Zaion-BM/SWAN_BSc_Version/README.md

# SWAN BSc Thesis
Smart Watering Automation Network (SWAN) is a university thesis project at BME-VIK-MIT

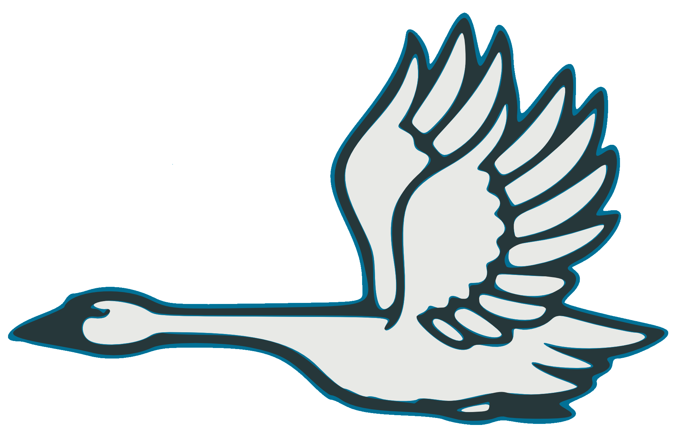
[picture p1: swan_logo.png]
SWAN logo
