Zaion-BM/SWAN_BSc_Version/Documents/neslab_prezi_hpd5lb.pptx

## Talaj nedvességtartalom mérés IoT eszközzel

Berta Máté
Konzulens:
Naszály Gábor

## Feladat

- Önálló laboratórium tanulságaiból kiindulva IoT alapú öntözőrendszer implementálása
- Talaj nedvességtartalom mérés kapacitív szenzorral
- A megoldás során elkészül:
  - Kapcsolási rajz és NYÁK
  - Szoftver µC-re
  - Szoftver központi számítógépre

## Rendszerterv 1.

Smart Watering Automation Network– S.W.A.N.

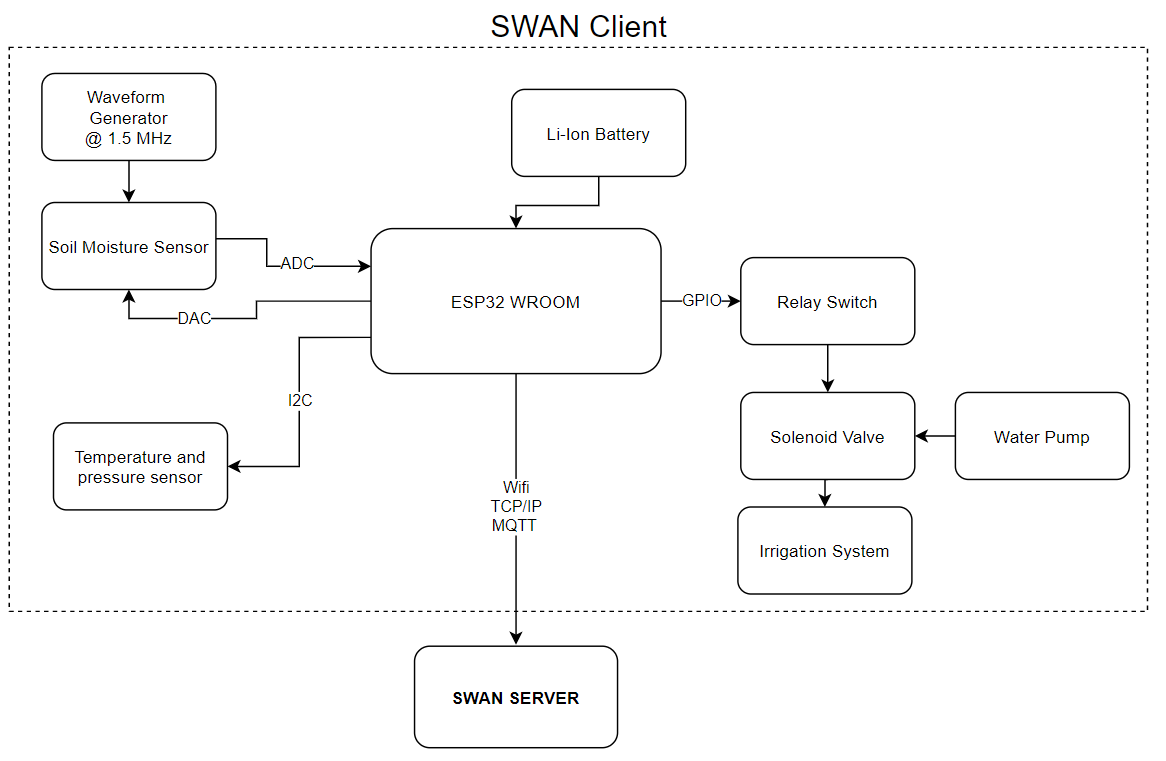
[picture p2: figure]

## Rendszerterv 2.

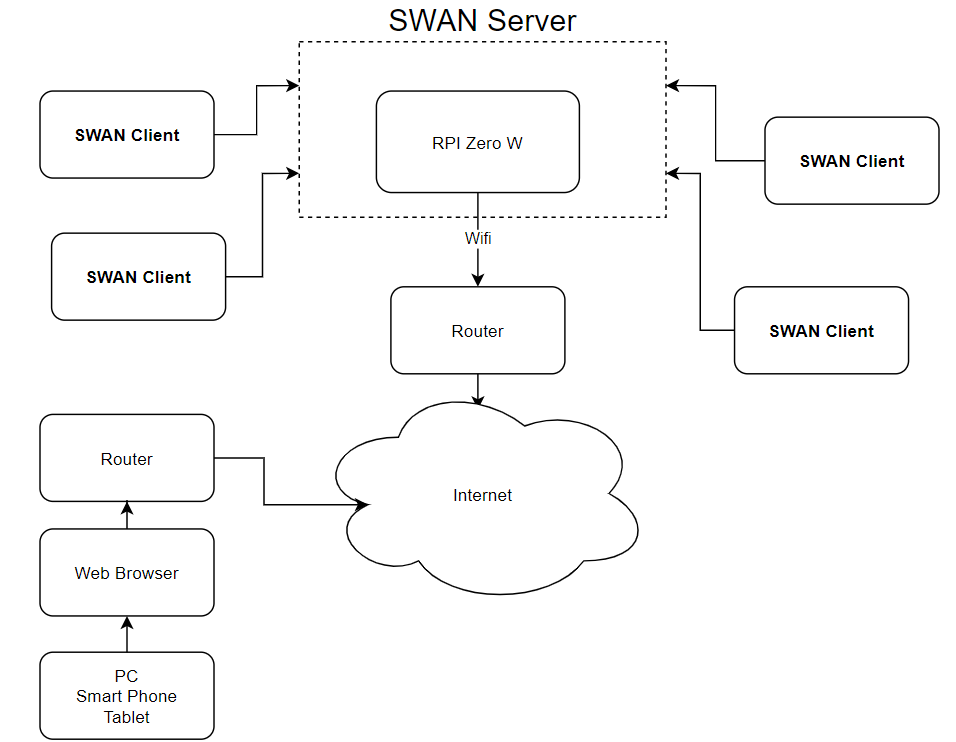
[picture p3: figure]

## Kapacitív talaj nedvességtartalom mérés

- S[%] = (m_(H2O))/(m_(talaj))
- Talajból kioldott ionok
- ε_r^(∗) = ε_r^(′) − j∙ε_r^(′′) = ε_r^(′) − j(ε_(relax)^(′′) + (σ_(dc))/(2πfε_0))
- C = ε_r^(∗) ε_0 G_0
- A kapacitás több fontos tényezőtől függ:
  - Frekvencia
  - Talaj vezetőképessége (talaj minőség)
  - Szenzor geometria

## Eredeti és módosított szenzor kapcsolási rajza

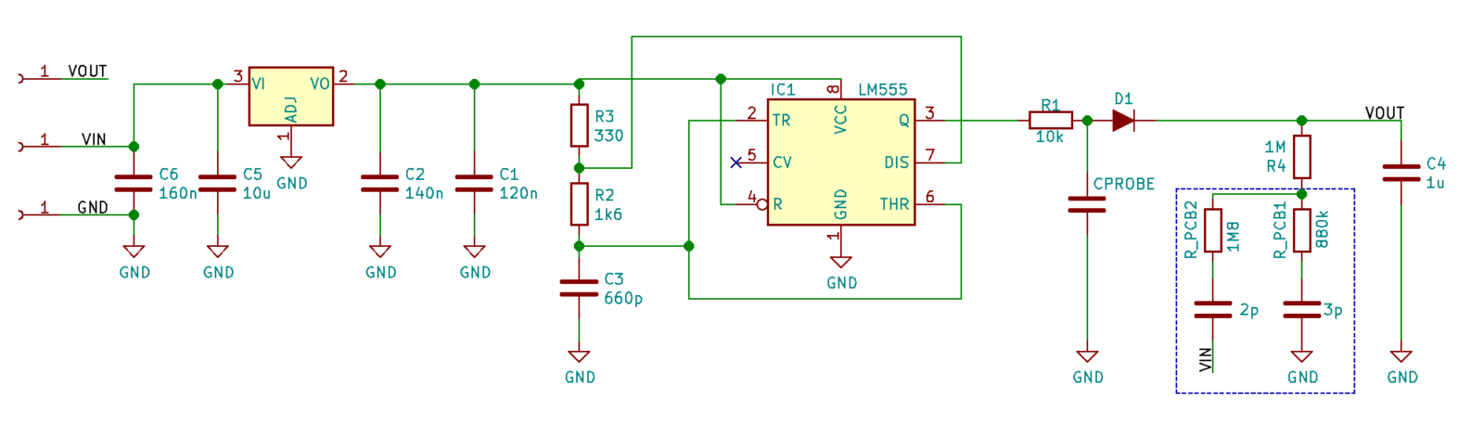
[picture p4: figure]
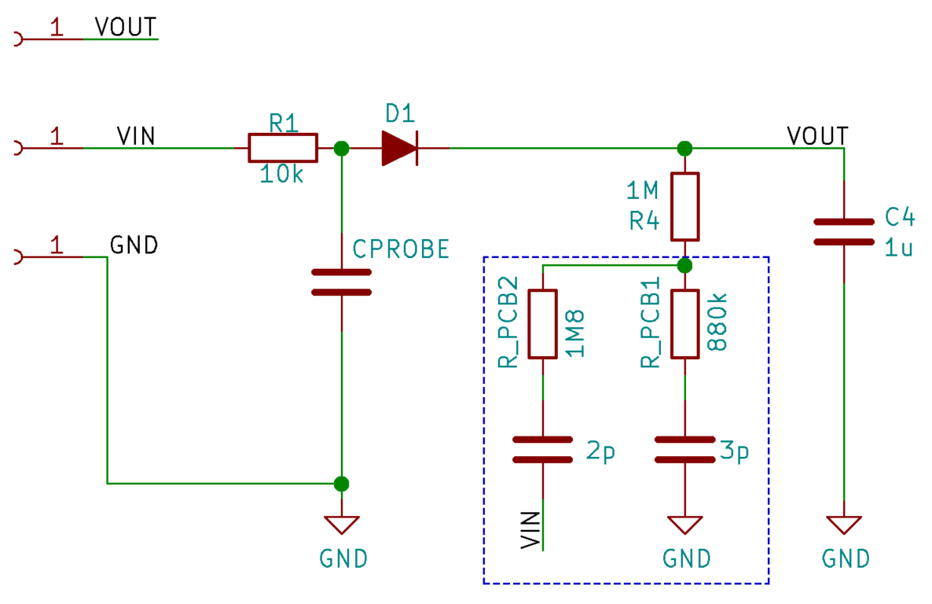
[picture p5: figure]
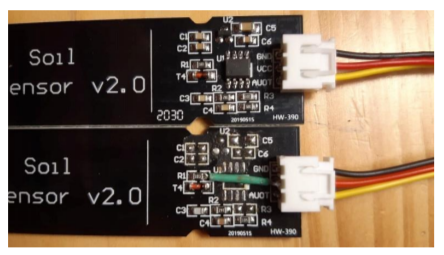
[picture p6: figure]

## Kalibrációs mérés 1

- Célja kettős! (karakterisztika, vizsgálódás)
- Metodikája szakirodalomból átvett

Tanulságai:
Szenzor geometria jelentős fontosságú
Gerjesztőjel spektruma nem okoz szignifikáns változást a karakterisztikában

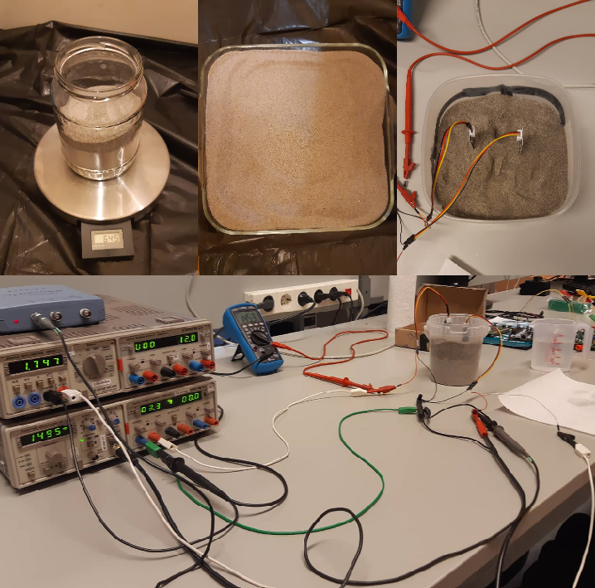
[picture p7: figure]

## Kalibrációs mérés 2

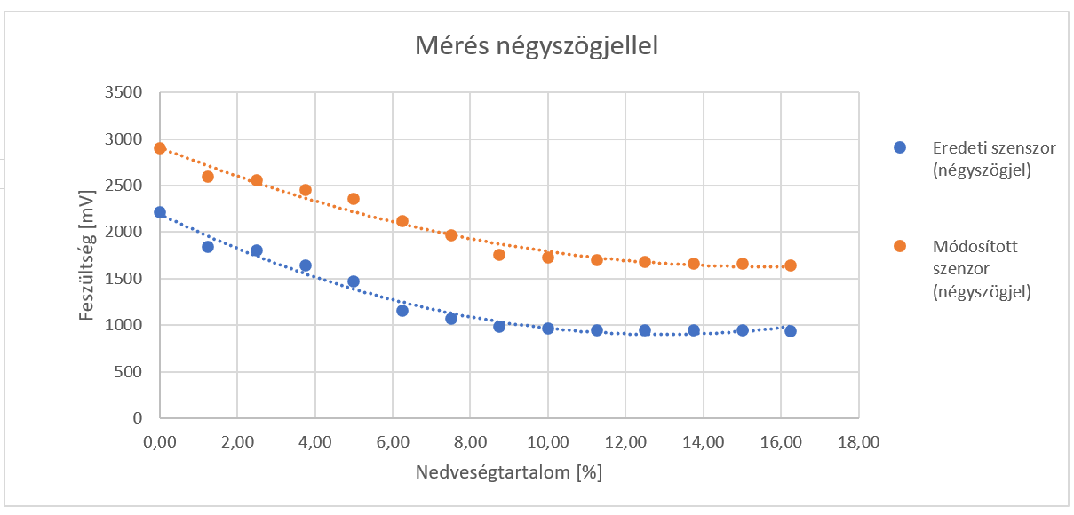
[picture p8: figure]

- Karakterisztika jellege nem változik
- „Lineáris” szakaszok meredeksége
- SWAN kliens mérőjele négyszögjel

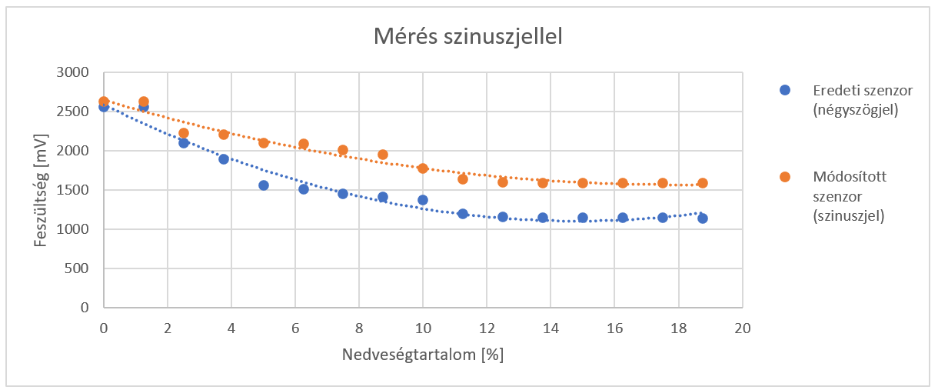
[picture p9: figure]

## Hardver követelmények (SWAN kliens)

- Akkumulátoros üzem
- Mágnes szelep vezérlése
- Alacsony költség (egyszerre több kliens használatának céljából)
- Kültéri villanyszereléshez használt IP65 doboz határozta meg a méreteket

## Szoftver követelmények (SWAN kliens & szerver)

- Kliens
  - Alacsony fogyasztás
  - Megbízható működés (beavatkozó szerv hiba esetén ne lépjen működésbe)
  - Több kliensre kerül a firmware
- Szerver:
  - Több kliens kezelésére alkalmas
  - Gyors reakció idő
  - Folyamatos elérhetőség

## Hardver implementáció

- µC működéséhez szükséges elemek
  - Passzív komponensek + csökkentett zajú környezet
- Tápfeszültség előállító hálózat
  - LDO 3.3V, 1A, 250mV dropout, 0.1 µA (shutdown)
- Akkumulátor töltő áramkör
- I2C & UART busz
- Galvanikusan leválasztott relé kapcsolás
- Mérőjel hardveres előállítása (!)
- ESD és fordított polaritás védelem

## Kliens PCB

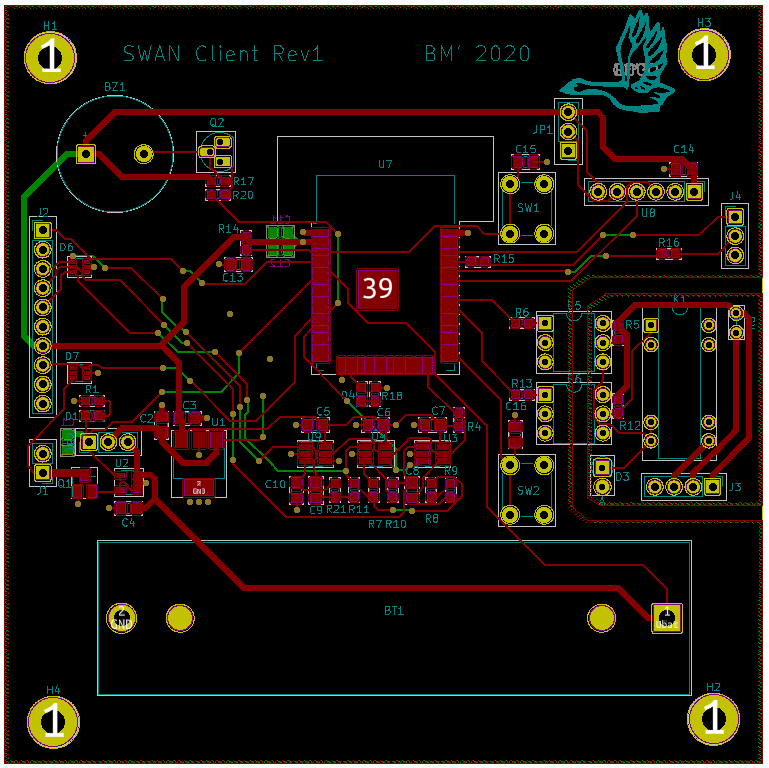
[picture p10: figure]
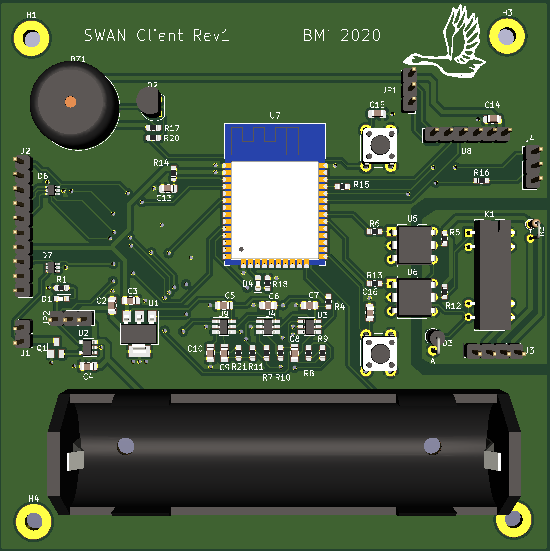
[picture p11: figure]

## Firmware implementáció 1.

- FreeRTOS módosított változata
  - xTaskCreatePinnedToCore(), vTaskSuspendAll()
- Deep sleep (fejlesztőkörnyezet korlátozó tényező)
  - 10µA
- Double -> Float
- PubSubClient (!)
- ArduinoJSON v6

## Firmware implementáció 2.

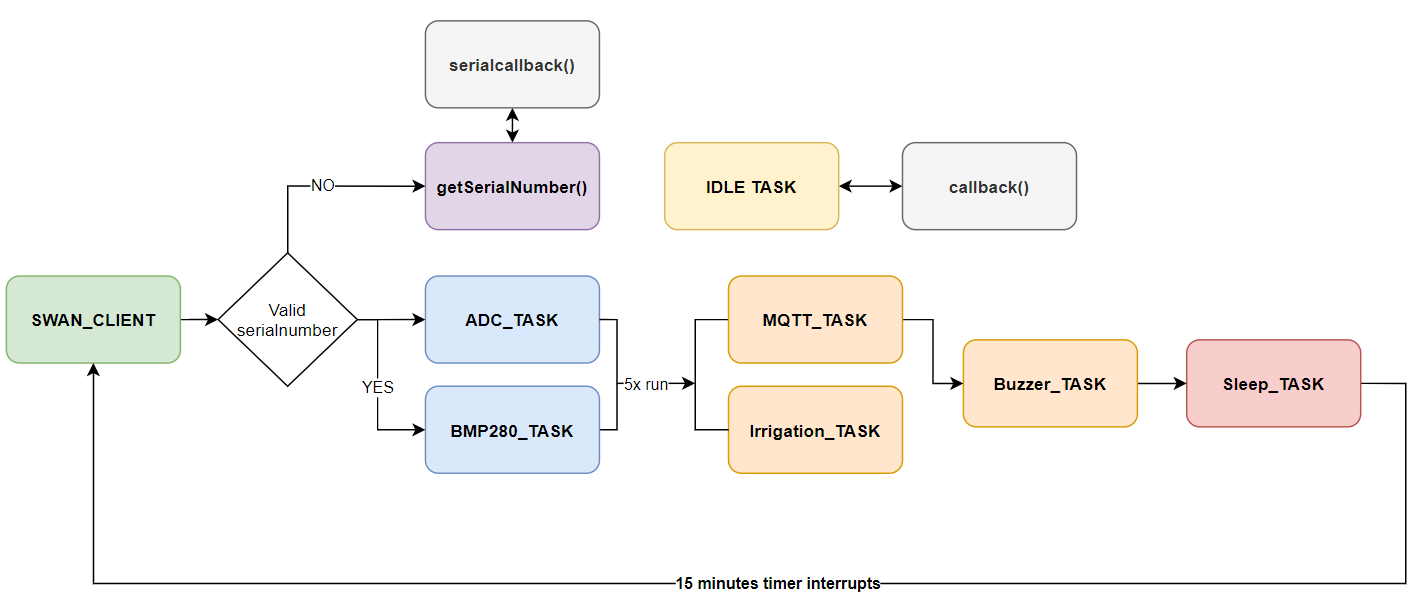
[picture p12: figure]

## Szerver implementáció 1.

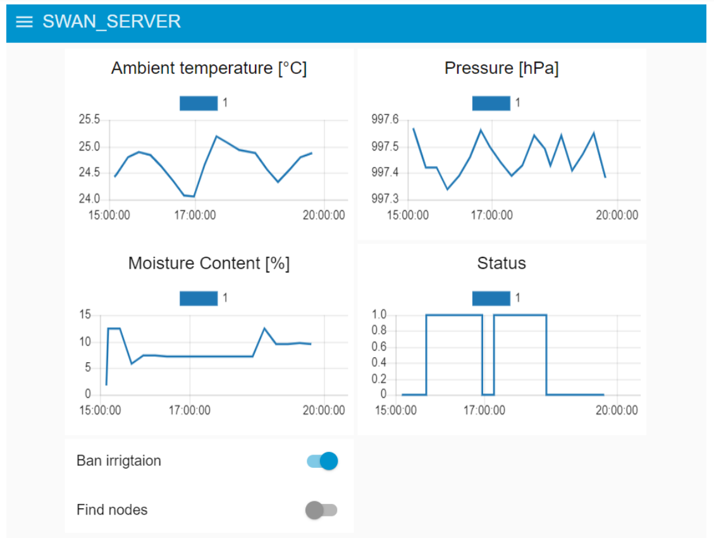
[picture p13: figure]

- Raspberry Pi Zero W
- DietPi
- NodeRED
  - SQLite
  - Mosquitto

## Szerver implementáció 2.

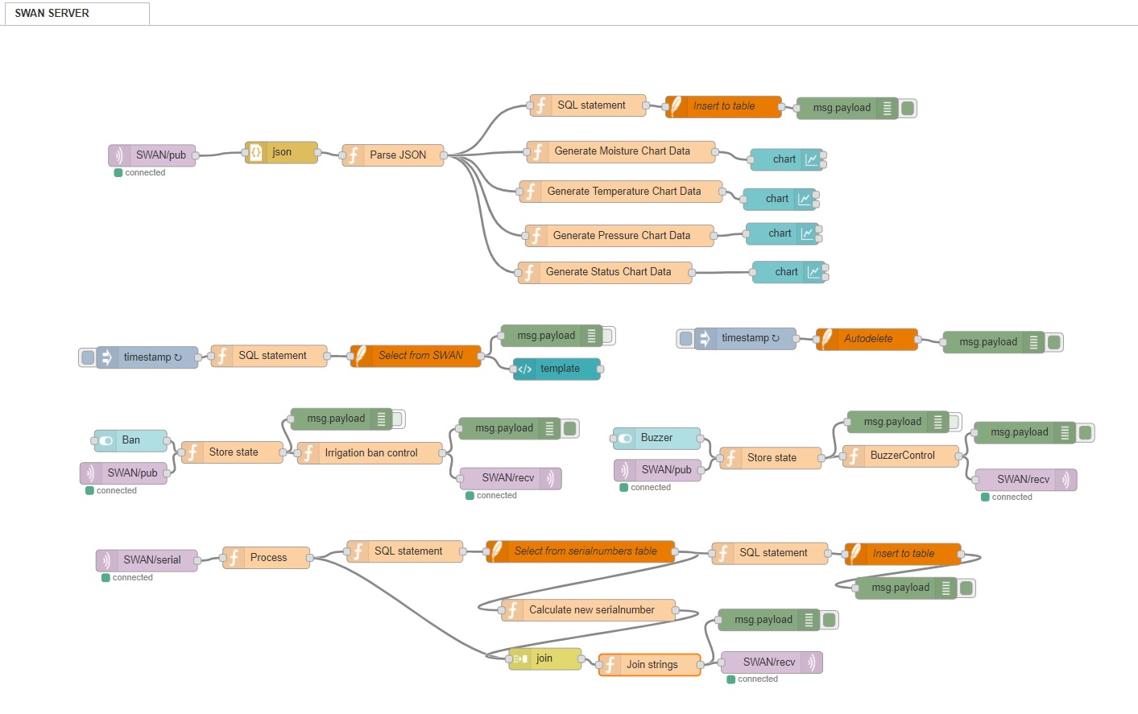
[picture p14: figure]

## Eredmények és továbbfejlesztési lehetőségek

- Eredmények:
  - Működő prototípus
  - Sikeres talaj nedvességtartalom mérés
  - 2021 nyarán „éles” körülmények között tesztelhető
- Tovább fejlesztési lehetőségek:
  - Átlag fogyasztás csökkentése ( ~4 mA, ~26 nap)
  - Költség csökkentése (akkumulátor költsége 22%)
  - Szenzor geometriájának változtatása
  - Szoftver időzítések optimalizálása
  - Debug üzenetek elhagyása (minimalizálás)

## Bírálói kérdések megválaszolása

- Adjon javaslatot a WiFi-n alapuló vezeték nélküli kapcsolat alternatívájára, amely alacsony fogyasztású rádiós összeköttetést valósíthat meg a rendszerkomponensek között.
  - LoRAWAN
    - Class A működéssel
- Adjon javaslatot alternatív energiaellátásra, amellyel az akkumulátor töltése megoldható. Milyen költségvonzata van egy ilyen rendszerkomponensnek?
  - Energy harvesting jellegű megoldás
    - Pl. Napelemcella
      - Cella : 1000 Ft - 8000 Ft (4-5W)
      - Boost SMPS ~ 1000 Ft (4-5W)
      - Kisebb akkumulátor sokkal olcsóbban elérhető
