Zaion-BM/SWAN_BSc_Version/szinusz.png

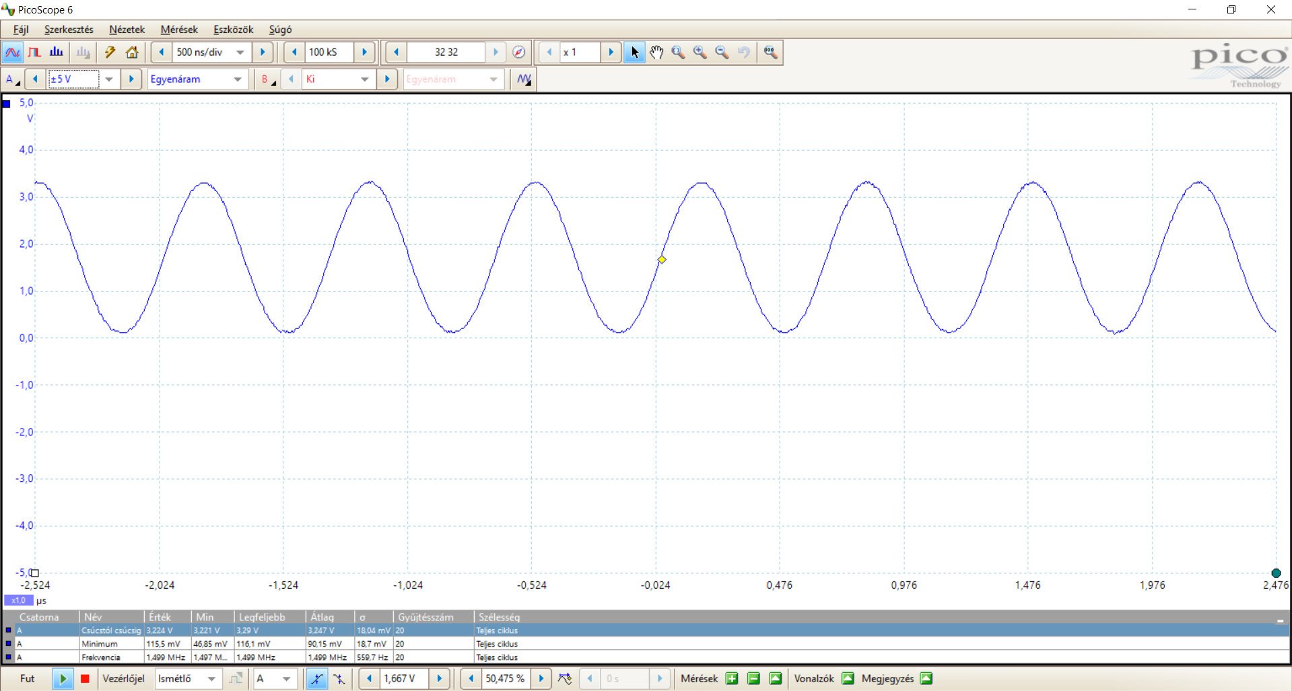
szinusz.png
