Zaion-BM/SWAN_BSc_Version/System design/SWAN_Rendszerterv.pdf

# SWAN Client

# Rendszerterv

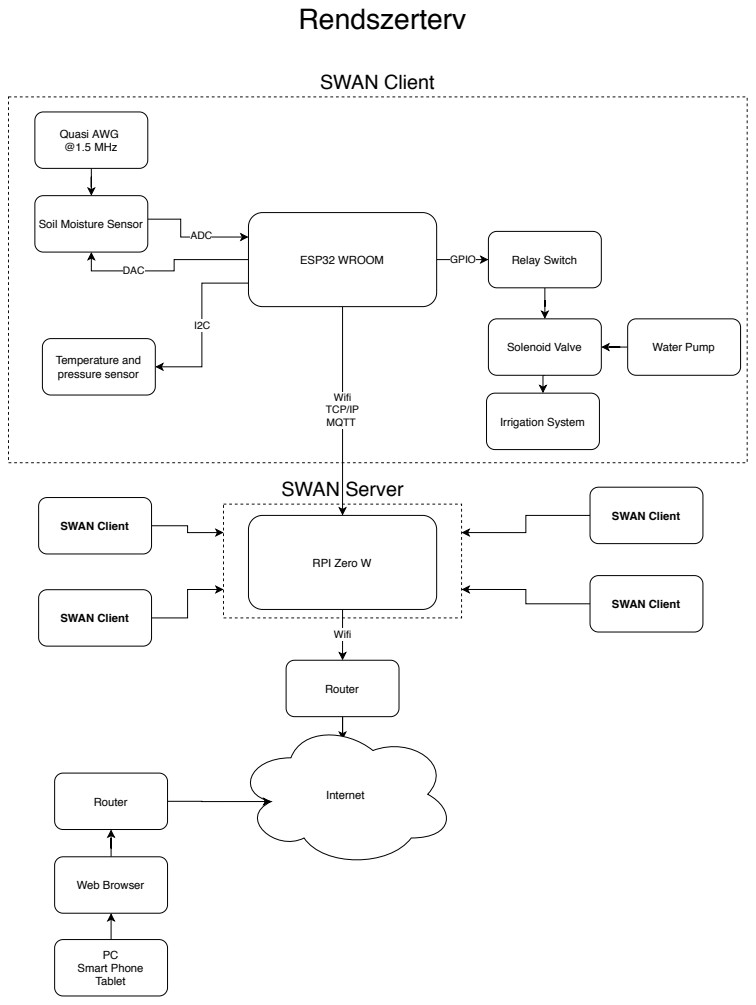
[picture p89: page 1]
ADC; GPIO; Wifi TCP/IP MQTT; DAC; ESP32 WROOM; Wifi; RPI Zero W; Temperature and pressure sensor; Relay Switch; Solenoid Valve; Water Pump; Irrigation System; Router; Internet; SWAN Server; Web Browser; PC Smart Phone Tablet; SWAN Client; Quasi AWG @1.5 MHz

Soil Moisture Sensor
