Zaion-BM/SWAN_BSc_Version/SWAN_Client_Rev0/schematic.pdf

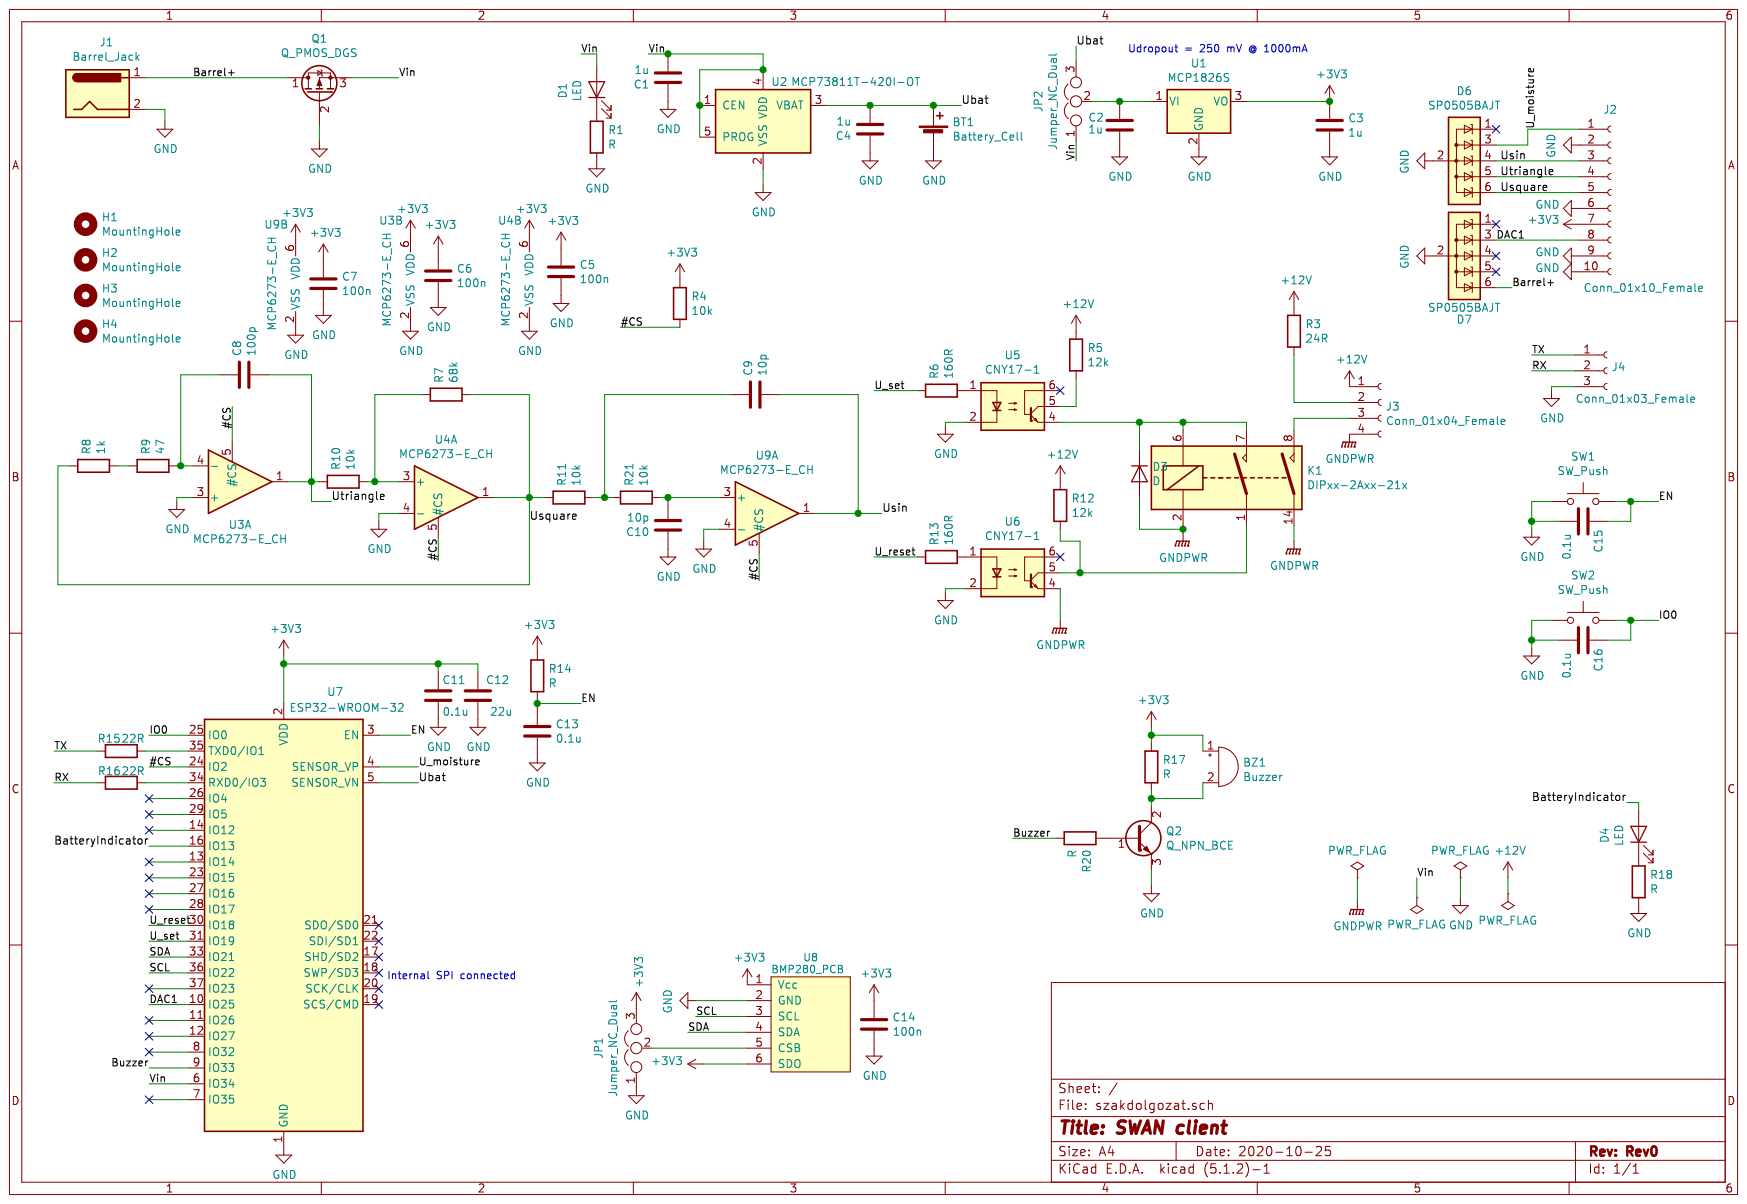
[picture p90: page 1]
