Zaion-BM/SWAN_BSc_Version/SWAN_Client_Rev0/OutJob/szakdolgozat-B_Cu.pdf

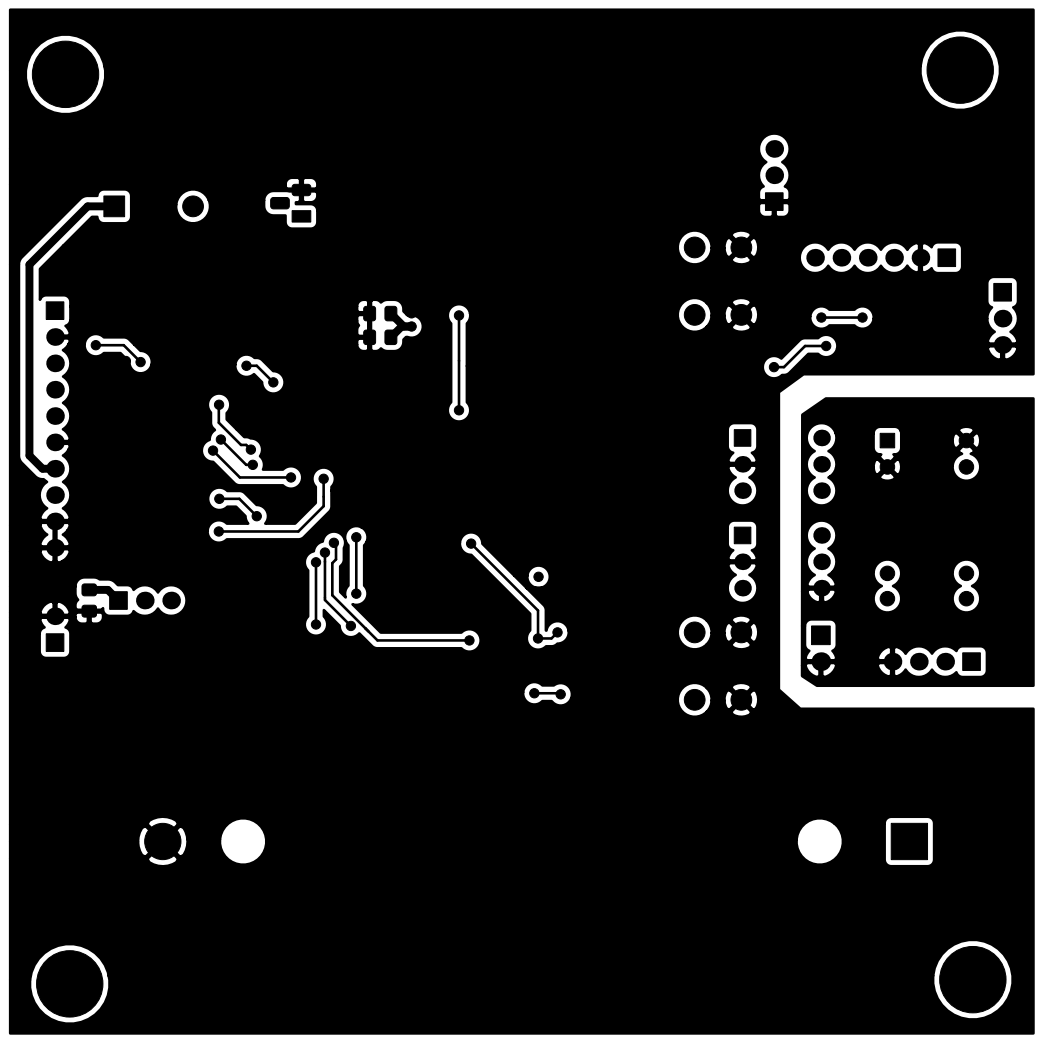
[picture p91: page 1]
