Zaion-BM/SWAN_BSc_Version/SWAN_Client_Rev0/OutJob/szakdolgozat-B_Mask.pdf

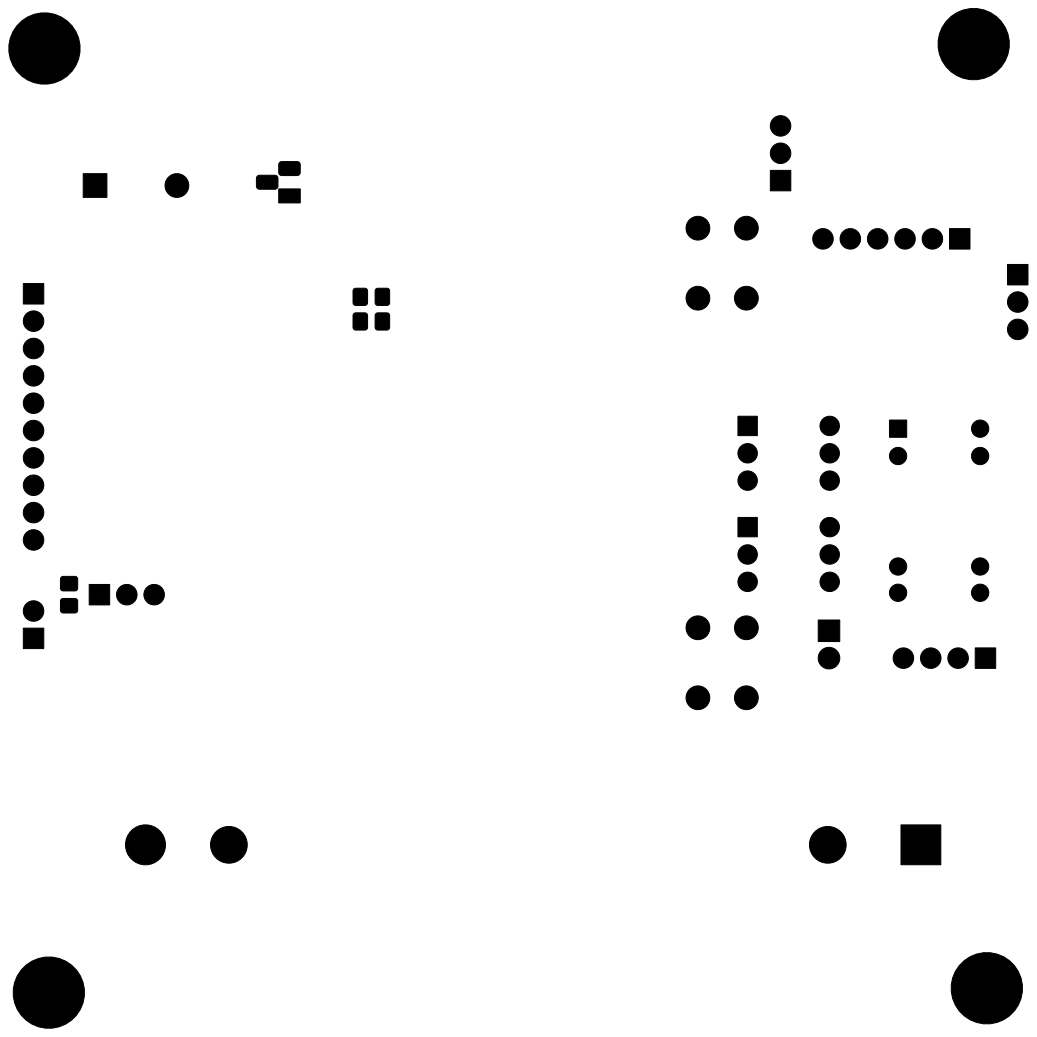
[picture p92: page 1]
