Zaion-BM/SWAN_BSc_Version/SWAN_Client_Rev0/OutJob/szakdolgozat-B_SilkS.pdf

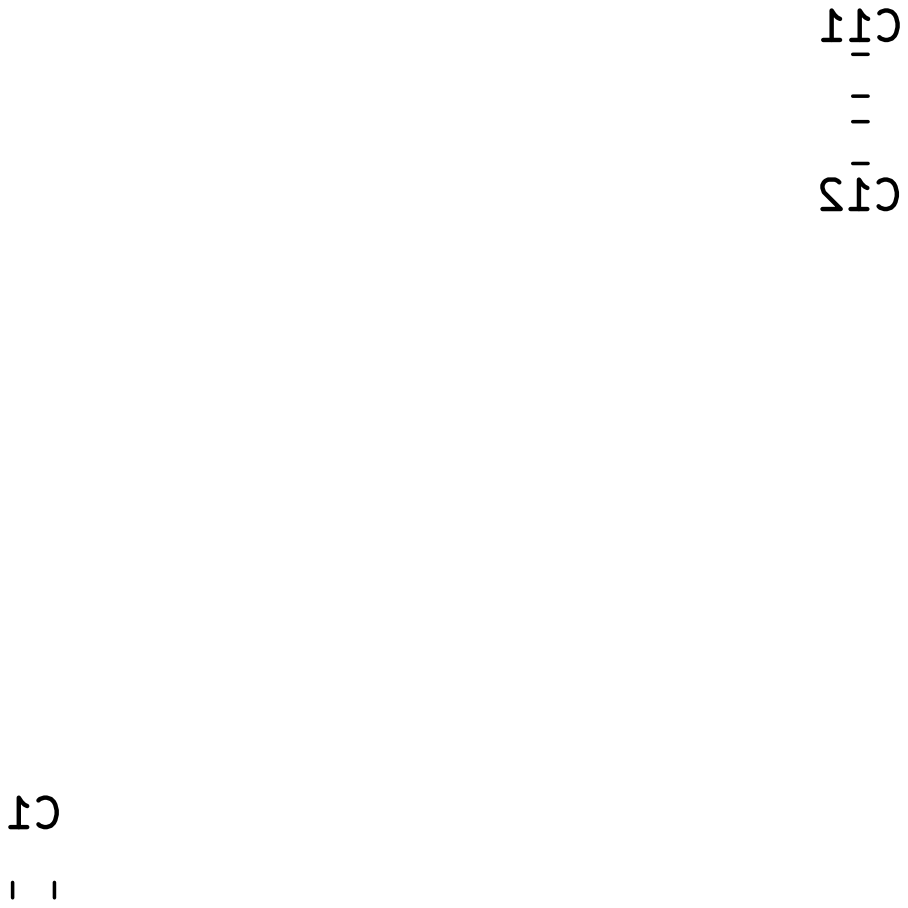
[picture p93: page 1]
