Zaion-BM/SWAN_BSc_Version/SWAN_Client_Rev0/OutJob/szakdolgozat-F_Cu.pdf

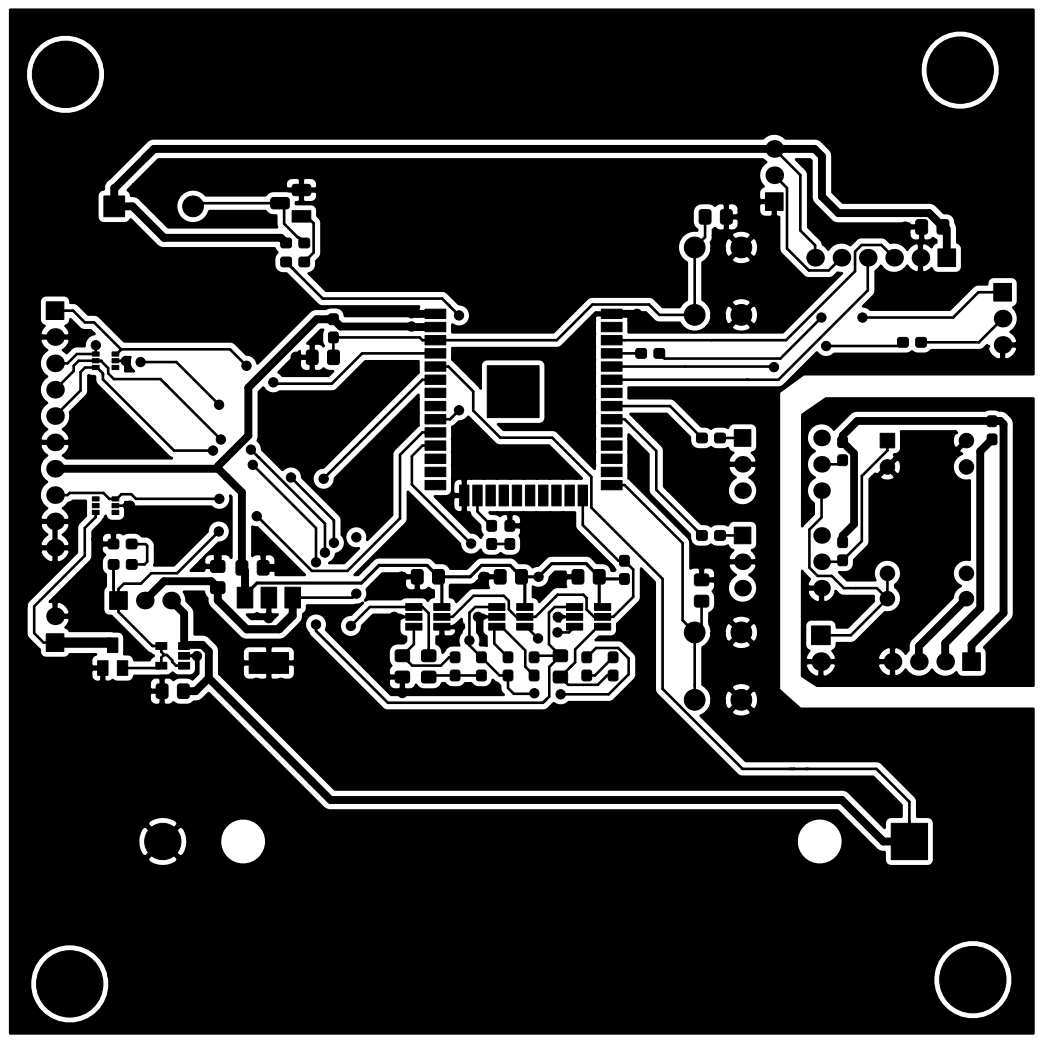
[picture p94: page 1]
