Zaion-BM/SWAN_BSc_Version/SWAN_Client_Rev0/OutJob/szakdolgozat-F_Mask.pdf

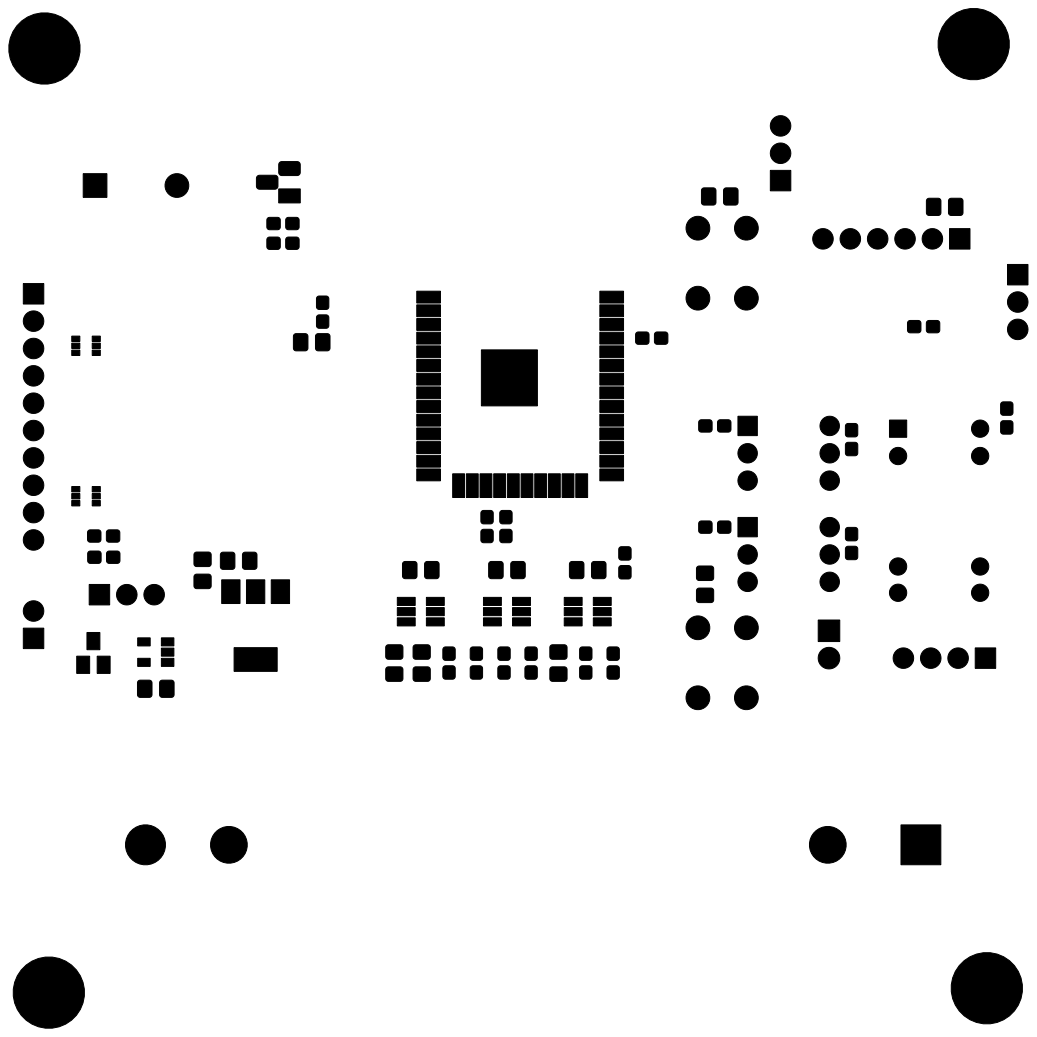
[picture p95: page 1]
