Zaion-BM/SWAN_BSc_Version/SWAN_Client_Rev0/OutJob/szakdolgozat-F_SilkS.pdf

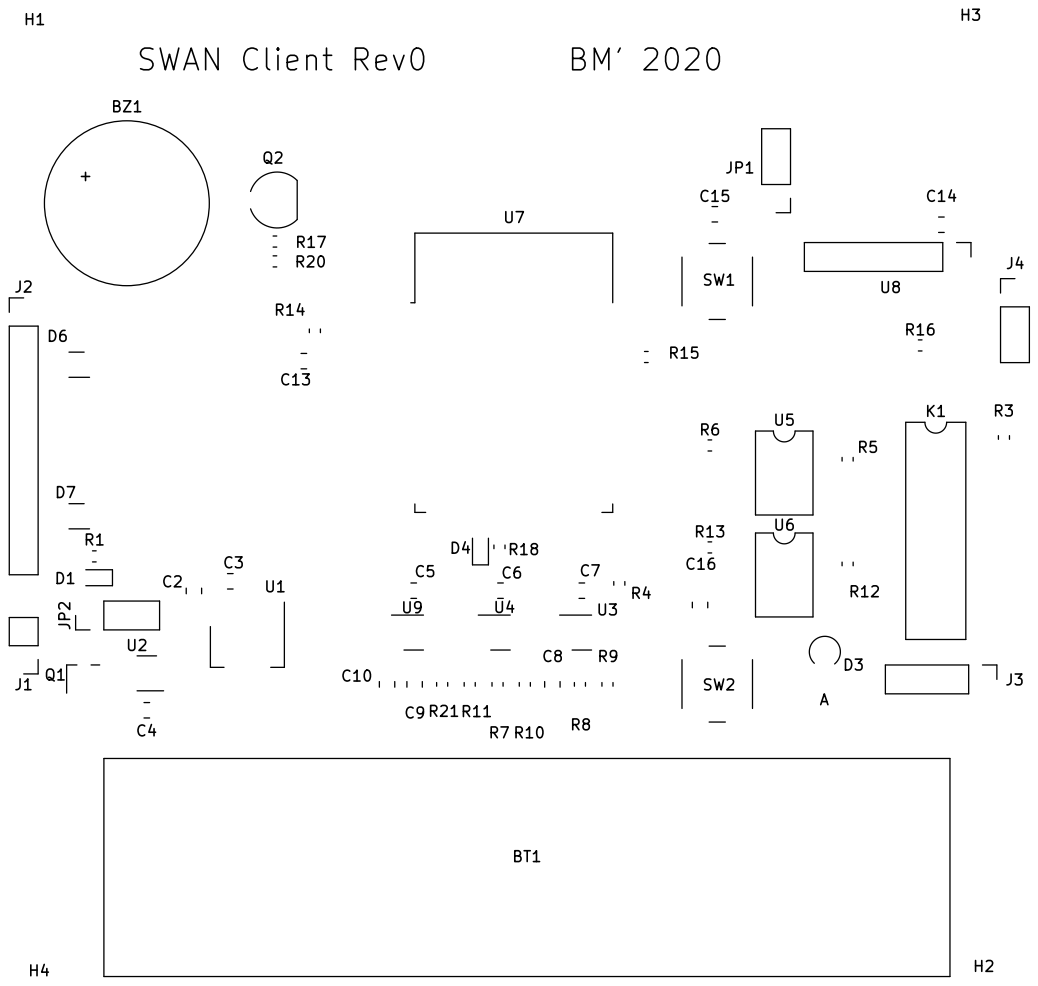
[picture p96: page 1]
