Zaion-BM/SWAN_BSc_Version/SWAN_Client_Rev0/szakdolgozat.kicad_pcb

## KiCad design SWAN_Client_Rev0/szakdolgozat.kicad_pcb (2020-11-16, an earlier design)

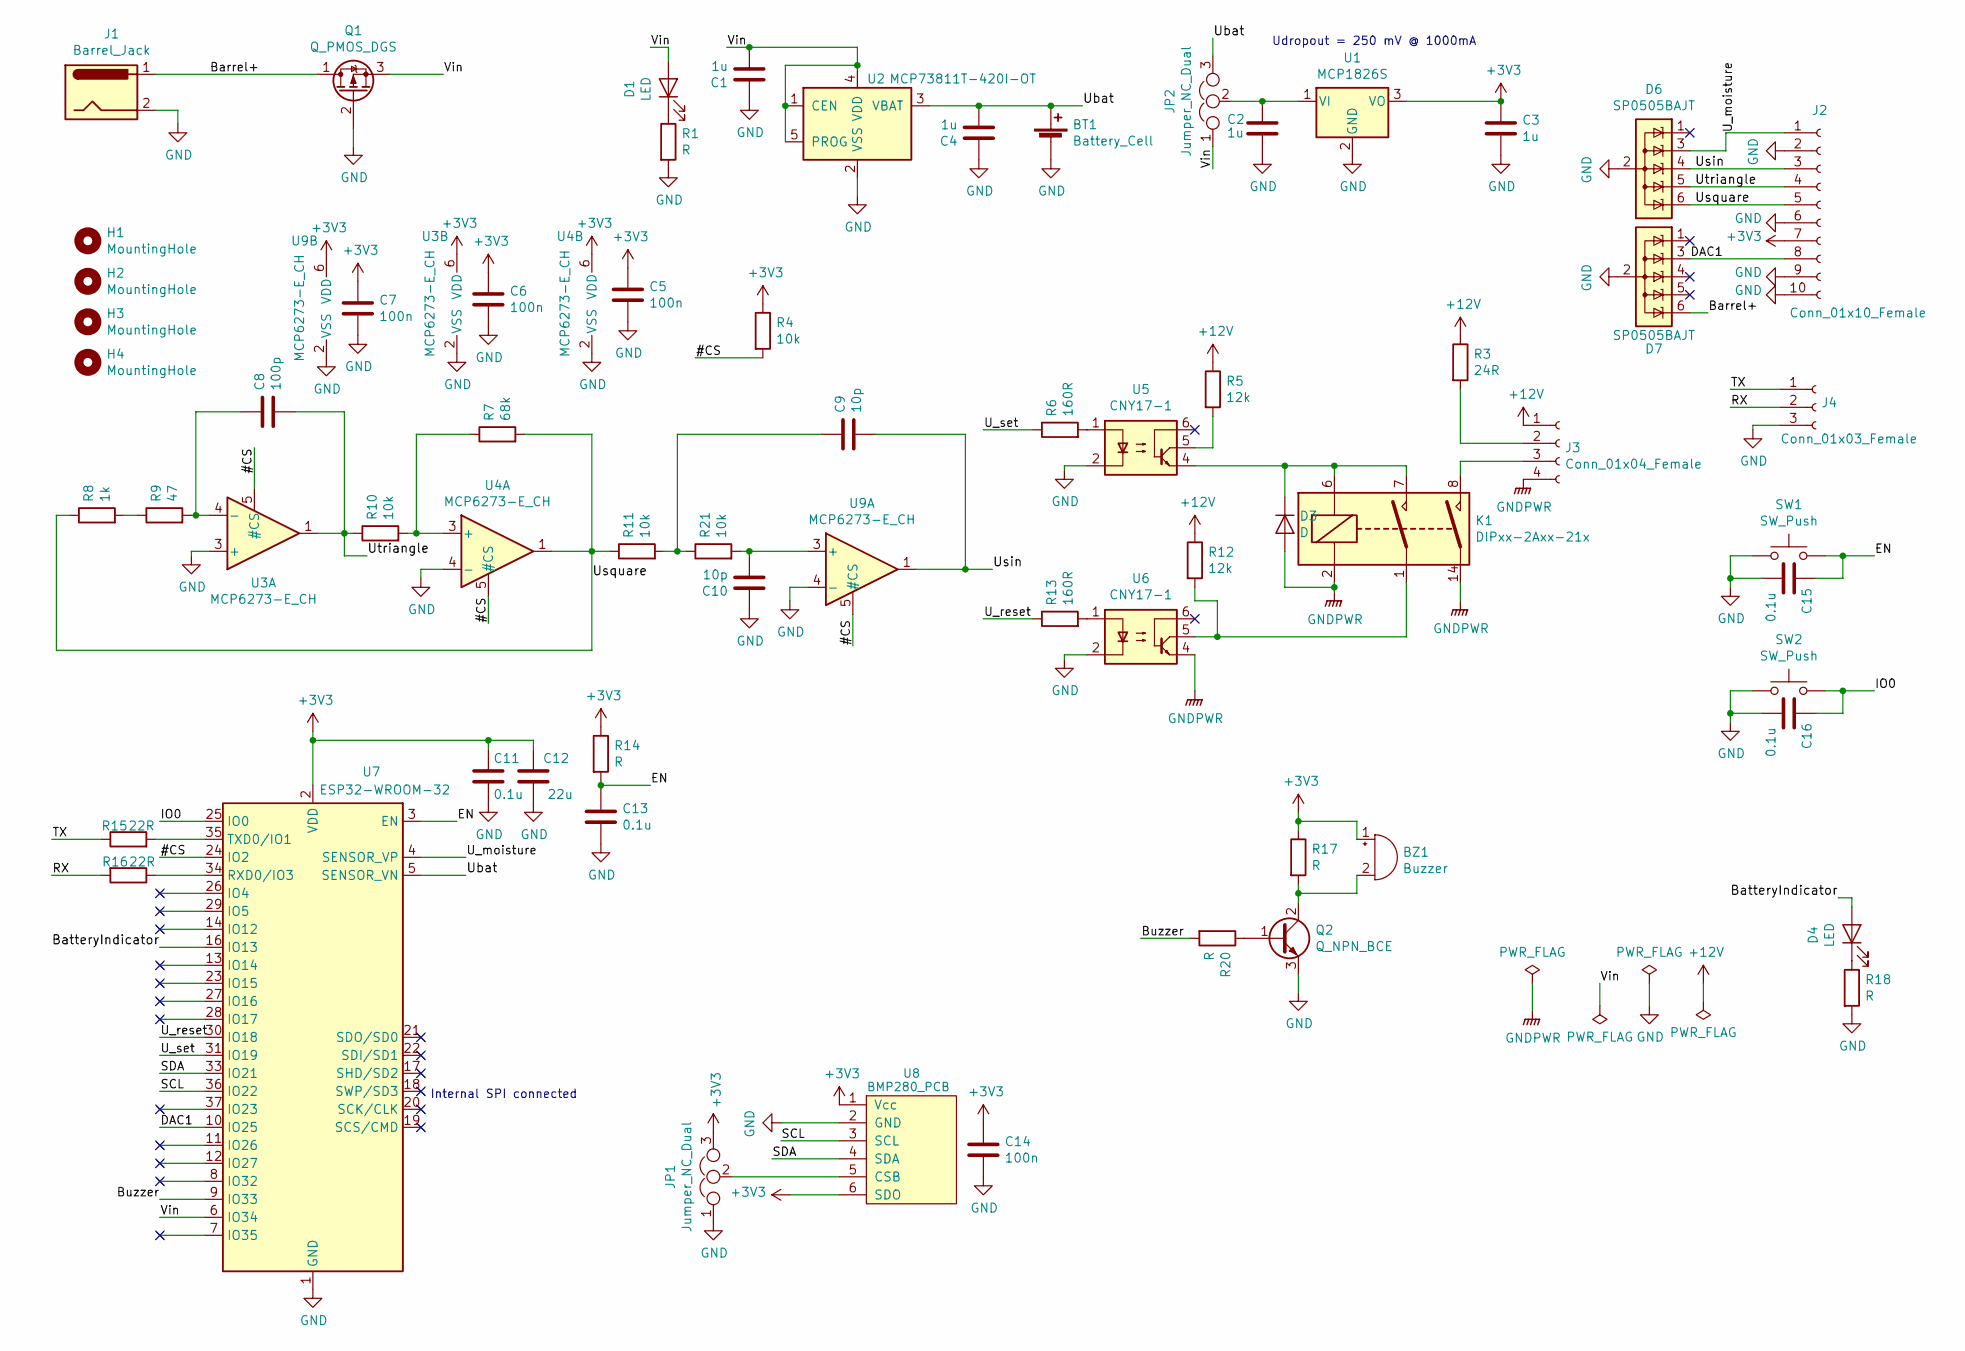
[picture p97: schematic szakdolgozat.sch, SWAN client]

Parts:
BT1: Battery_Cell; BatteryHolder_MPD_BH-18650-PC2
BZ1: Buzzer; Buzzer_15x7.5RM7.6
C1, C2, C3, C4: 1u; C_0805_2012Metric_Pad1.15x1.40mm_HandSolder
C5, C6, C7, C14: 100n; C_0805_2012Metric_Pad1.15x1.40mm_HandSolder
C8: 100p; C_0805_2012Metric_Pad1.15x1.40mm_HandSolder
C9, C10: 10p; C_0805_2012Metric_Pad1.15x1.40mm_HandSolder
C11, C13, C15, C16: 0.1u; C_0805_2012Metric_Pad1.15x1.40mm_HandSolder
C12: 22u; C_0805_2012Metric_Pad1.15x1.40mm_HandSolder
D1, D4: LED; LED_0603_1608Metric_Pad1.05x0.95mm_HandSolder
D3: D; D_A-405_P2.54mm_Vertical_AnodeUp
D6, D7: SP0505BAJT; SOT-363_SC-70-6
H1, H2, H3, H4: MountingHole; MountingHole_3.2mm_M3_Pad
J1: Barrel_Jack; PinHeader_1x02_P2.54mm_Vertical
J2: Conn_01x10_Female; PinHeader_1x10_P2.54mm_Vertical
J3: Conn_01x04_Female; PinHeader_1x04_P2.54mm_Vertical
J4: Conn_01x03_Female; PinHeader_1x03_P2.54mm_Vertical
JP1, JP2: Jumper_NC_Dual; PinHeader_1x03_P2.54mm_Vertical
K1: DIPxx-2Axx-21x; Relay_StandexMeder_DIP_LowProfile
Q1: Q_PMOS_DGS; MySuperSOT-3
Q2: Q_NPN_BCE; TO-92_HandSolder
R1, R14, R17, R18, R20: R; R_0603_1608Metric_Pad1.05x0.95mm_HandSolder
R3: 24R; R_0603_1608Metric_Pad1.05x0.95mm_HandSolder
R4, R10, R11, R21: 10k; R_0603_1608Metric_Pad1.05x0.95mm_HandSolder
R5, R12: 12k; R_0603_1608Metric_Pad1.05x0.95mm_HandSolder
R6, R13: 160R; R_0603_1608Metric_Pad1.05x0.95mm_HandSolder
R7: 68k; R_0603_1608Metric_Pad1.05x0.95mm_HandSolder
R8: 1k; R_0603_1608Metric_Pad1.05x0.95mm_HandSolder
R9: 47; R_0603_1608Metric_Pad1.05x0.95mm_HandSolder
R15, R16: 22R; R_0603_1608Metric_Pad1.05x0.95mm_HandSolder
SW1, SW2: SW_Push; SW_PUSH_6mm
U1: MCP1826S; SOT-223-3_TabPin2
U2: MCP73811T-420I-OT; SOT-23-5
U3, U4, U9: MCP6273-E_CH; SOT-23-6_Handsoldering
U5, U6: CNY17-1; DIP-6_W7.62mm
U7: ESP32-WROOM-32
U8: BMP280_PCB; PinHeader_1x06_P2.54mm_Vertical

Connections:
+3V3: BZ1.1 (-), C3.1, C5.1, C6.1, C7.1, C11.1, C12.1, C14.1, J2.7, JP1.3, R4.1, R14.1, R17.1, U1.3 (VO), U3.6 (VDD), U4.6 (VDD), U7.2 (VDD), U8.1 (Vcc), U8.6 (SDO), U9.6 (VDD)
+12V: J3.1, R3.1, R5.1, R12.1
/#CS: R4.2, U3.5 (#CS), U4.5 (#CS), U7.24 (IO2), U9.5 (#CS)
/Barrel+: D7.6 (K), J1.1, Q1.1 (D)
/BatteryIndicator: D4.2 (A), U7.16 (IO13)
/Buzzer: R20.2, U7.9 (IO33)
/DAC1: D7.3 (K), J2.8, U7.10 (IO25)
/EN: C13.1, C15.1, R14.2, SW1.2, U7.3 (EN)
/IO0: C16.1, SW2.2, U7.25 (IO0)
/RX: J4.2, R16.2
/SCL: U7.36 (IO22), U8.3 (SCL)
/SDA: U7.33 (IO21), U8.4 (SDA)
/TX: J4.1, R15.1
/U_moisture: D6.3 (K), J2.1, U7.4 (SENSOR_VP)
/U_reset: R13.1, U7.30 (IO18)
/U_set: R6.1, U7.31 (IO19)
/Ubat: BT1.1 (+), C4.2, JP2.3, U2.3 (VBAT), U7.5 (SENSOR_VN)
/Usin: C9.2, D6.4 (K), J2.3, U9.1
/Usquare: D6.6 (K), J2.5, R7.2, R8.1, R11.1, U4.1
/Utriangle: C8.2, D6.5 (K), J2.4, R10.1, U3.1
/Vin: C1.2, D1.2 (A), JP2.1, Q1.3 (S), U2.1 (CEN), U2.4 (VDD), U2.5 (PROG), U7.6 (IO34)
GNDPWR: D3.2 (A), J3.4, K1.2, K1.14, U6.4
unnamed: BZ1.2 (+), Q2.2 (C), R17.2
unnamed: C2.1, JP2.2, U1.1 (VI)
unnamed: C8.1, R9.2, U3.4 (-)
unnamed: C9.1, R11.2, R21.1
unnamed: C10.2, R21.2, U9.3 (+)
unnamed: D1.1 (K), R1.1
unnamed: D3.1 (K), K1.6, K1.7, U5.4
unnamed: D4.1 (K), R18.1
unnamed: J3.2, R3.2
unnamed: J3.3, K1.8
unnamed: JP1.2, U8.5 (CSB)
unnamed: K1.1, R12.2, U6.5
unnamed: Q2.1 (B), R20.1
unnamed: R5.2, U5.5
unnamed: R6.2, U5.1
unnamed: R8.2, R9.1
unnamed: R7.1, R10.2, U4.3 (+)
unnamed: R13.2, U6.1
unnamed: R15.2, U7.35 (TXD0/IO1)
unnamed: R16.1, U7.34 (RXD0/IO3)

Notes on the sheet:
Internal SPI connected
Udropout = 250 mV @ 1000mA

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
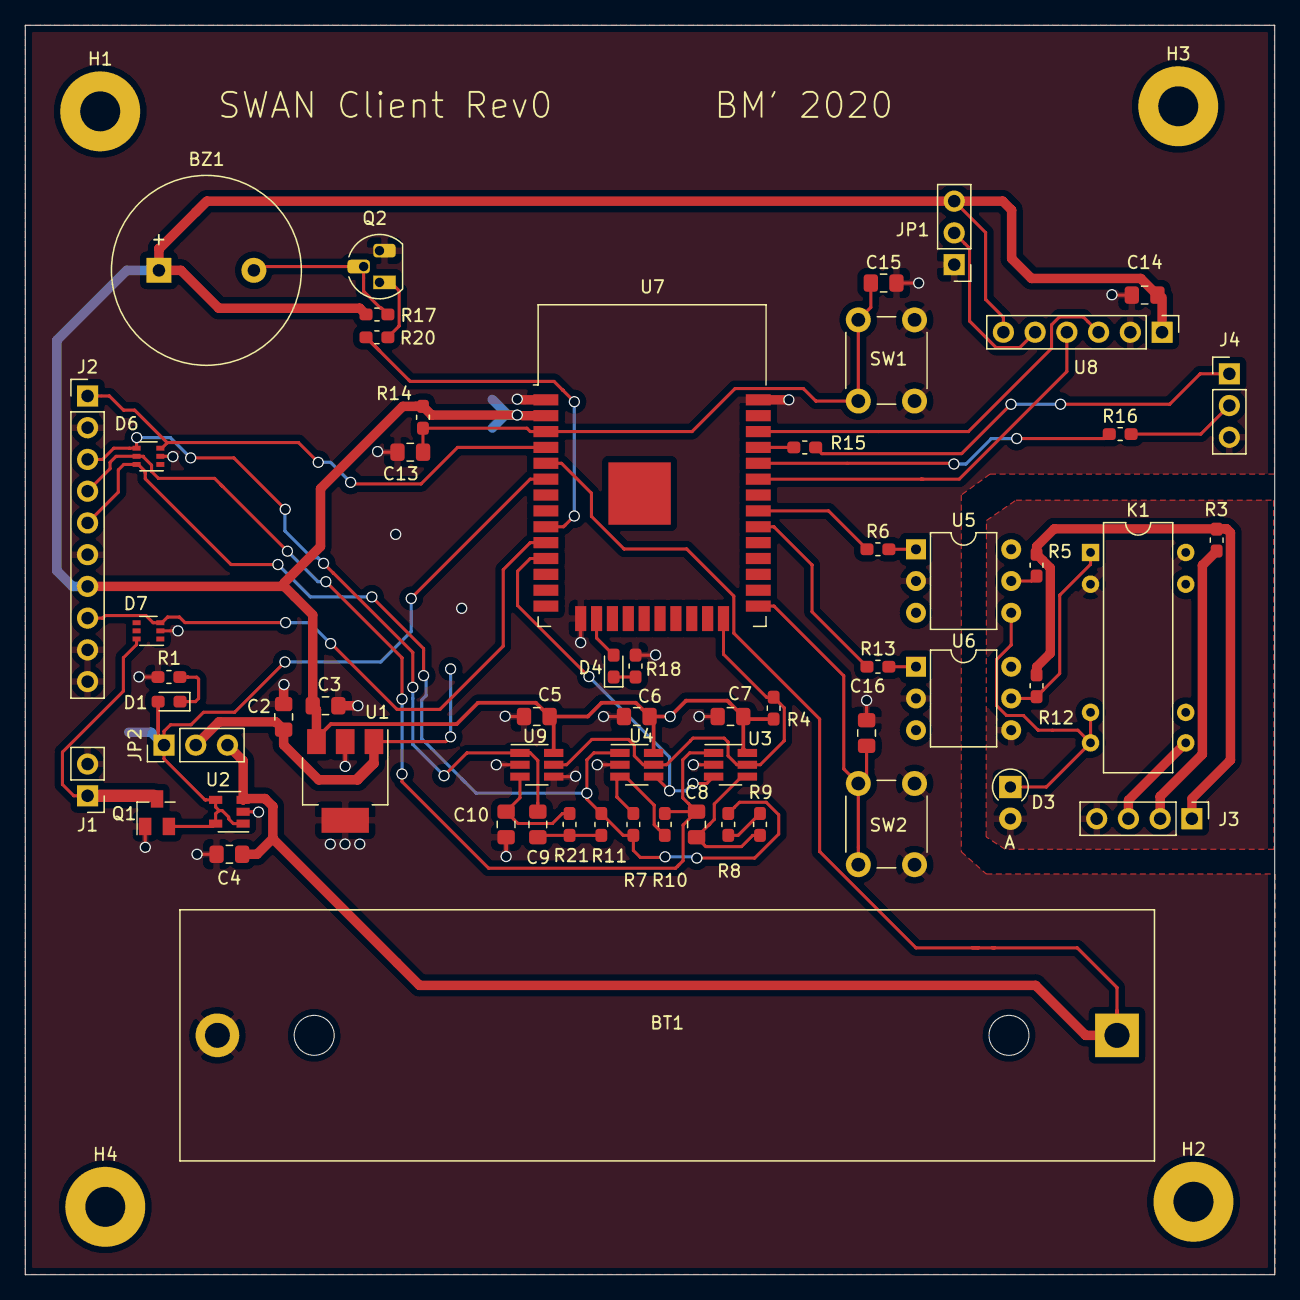
[picture p98: board szakdolgozat.kicad_pcb from above]

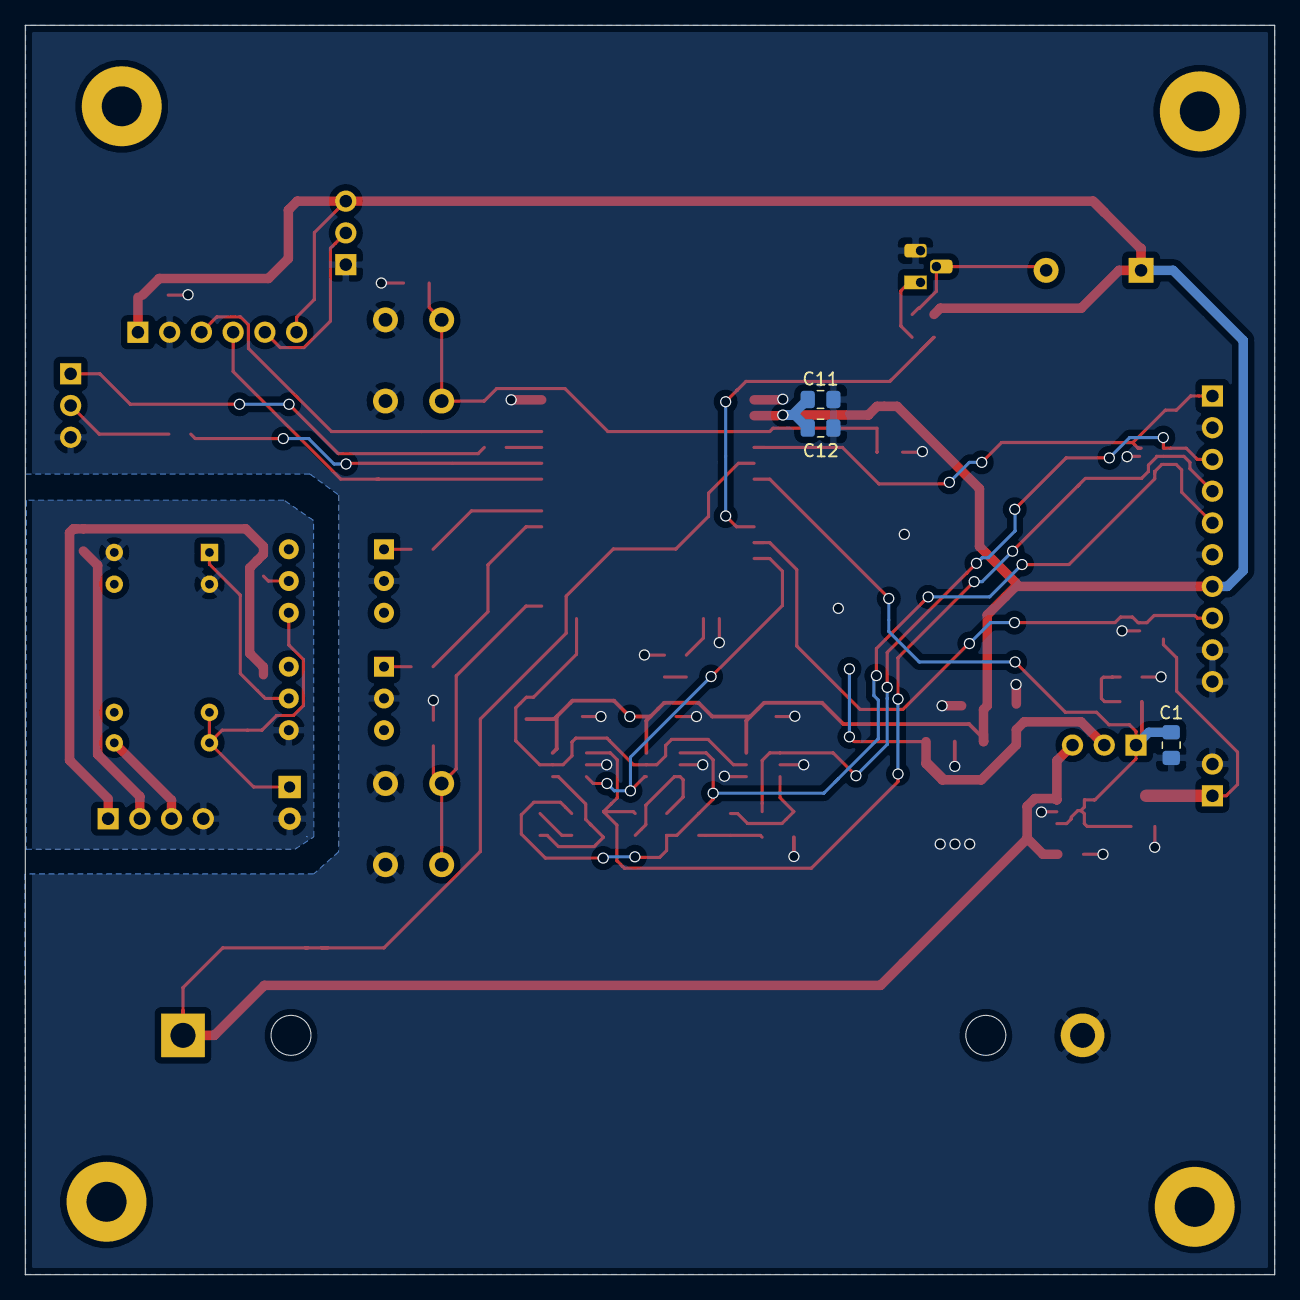
[picture p99: board szakdolgozat.kicad_pcb from below]

Board: 2 copper layers, 100.0 x 100.0 mm, 66 parts (3 on the bottom side), 44 nets.
