Zaion-BM/SWAN_BSc_Version/SWAN_CLIENT/DAC_task.ino

#define Num_Samples  112   //  number of dample of signal

void DAC_TASK(void *pvParameters){
  int i = 0;
  
  static byte WaveFormTable[Num_Samples] = {
   // Sin wave 
    0x80, 0x83, 0x87, 0x8A, 0x8E, 0x91, 0x95, 0x98, 0x9B, 0x9E, 0xA2, 0xA5, 0xA7, 0xAA, 0xAD, 0xAF,
    0xB2, 0xB4, 0xB6, 0xB8, 0xB9, 0xBB, 0xBC, 0xBD, 0xBE, 0xBF, 0xBF, 0xBF, 0xC0, 0xBF, 0xBF, 0xBF,
    0xBE, 0xBD, 0xBC, 0xBB, 0xB9, 0xB8, 0xB6, 0xB4, 0xB2, 0xAF, 0xAD, 0xAA, 0xA7, 0xA5, 0xA2, 0x9E,
    0x9B, 0x98, 0x95, 0x91, 0x8E, 0x8A, 0x87, 0x83, 0x80, 0x7C, 0x78, 0x75, 0x71, 0x6E, 0x6A, 0x67,
    0x64, 0x61, 0x5D, 0x5A, 0x58, 0x55, 0x52, 0x50, 0x4D, 0x4B, 0x49, 0x47, 0x46, 0x44, 0x43, 0x42,
    0x41, 0x40, 0x40, 0x40, 0x40, 0x40, 0x40, 0x40, 0x41, 0x42, 0x43, 0x44, 0x46, 0x47, 0x49, 0x4B,
    0x4D, 0x50, 0x52, 0x55, 0x58, 0x5A, 0x5D, 0x61, 0x64, 0x67, 0x6A, 0x6E, 0x71, 0x75, 0x78, 0x7C
   };
   
   /*
   // Triangular wave table
   {
     0x80, 0x84, 0x89, 0x8D, 0x92, 0x96, 0x9B, 0x9F, 0xA4, 0xA8, 0xAD, 0xB2, 0xB6, 0xBB, 0xBF, 0xC4,
     0xC8, 0xCD, 0xD1, 0xD6, 0xDB, 0xDF, 0xE4, 0xE8, 0xED, 0xF1, 0xF6, 0xFA, 0xFF, 0xFA, 0xF6, 0xF1,
     0xED, 0xE8, 0xE4, 0xDF, 0xDB, 0xD6, 0xD1, 0xCD, 0xC8, 0xC4, 0xBF, 0xBB, 0xB6, 0xB2, 0xAD, 0xA8,
     0xA4, 0x9F, 0x9B, 0x96, 0x92, 0x8D, 0x89, 0x84, 0x7F, 0x7B, 0x76, 0x72, 0x6D, 0x69, 0x64, 0x60,
     0x5B, 0x57, 0x52, 0x4D, 0x49, 0x44, 0x40, 0x3B, 0x37, 0x32, 0x2E, 0x29, 0x24, 0x20, 0x1B, 0x17,
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
     0x00, 0x00, 0x00, 0x00, 0x00, 0x00, 0x00, 0x00, 0x00, 0x00, 0x00, 0x00, 0x00, 0x00, 0x00, 0x00
   }*/


  while(1) {
    dacWrite(25, WaveFormTable[i]);   //  output wave form
    i++;
    vTaskDelay(1); 
  }
}
