Zaion-BM/SWAN_BSc_Version/(commit log)

2020-11-06 PCB Rev0 added
    Rev0 went to prototype production
    [szakdolgozat-B_Cu.gbr, szakdolgozat-B_Mask.gbr, szakdolgozat-B_SilkS.gbr, szakdolgozat-Edge_Cuts.gbr, szakdolgozat-F_Cu.gbr, szakdolgozat-F_Mask.gbr, szakdolgozat-F_SilkS.gbr, szakdolgozat-NPTH.drl]
2020-11-06 Price of clientPCB added
    [price calculation.xlsx]
2020-11-06 schematic export added
2020-11-06 PCB layers pdf export added
2020-11-06 Initial client firmware added
    No WIFI, just I2C ADC and sleep
2020-11-16 Schematic documentation done
2020-11-16 Reference voltage for AWG is fixed
    [szakdolgozat.kicad_pcb]
2020-11-18 Deep sleep added, WIFI&MQTT STACKSIZE fixed
    [DAC_task.ino, MQTT.ino, SWAN_CLIENT.ino]
2020-11-23 2nd order Sallen-Key Low pass filter's bode plot
2020-11-27 Sensor measurement 11_27
    [szenzor_meres.xlsx]
2020-11-27 Deep sleep timer to be modified, but finished
2020-11-29 Server flow version 1.0
2020-12-05 Capacitive measurement documentation added
2020-12-07 Finalised document
    Pre consultant review.
    Current measurement missing.
